Electronic-Emily/WeatherMonitoringSensors/README.md

# Weather Monitoring Project
Wind Direction Sensor with Display showing arrow

## Purpose
The purpose of this project is to create a prototype outdoor real-time weather monitoring station. The data from the station will then be transmitted and displayed to update the user on the current weather conditions.
   
The station's environmental sensing abilities should include:
- Temperature
- Atmospheric Pressure
- Relative Humidity
- Wind Speed (anemometer)
- Wind Direction
- Light Brightness

## Solution

For the first proof of concept a Nucleo-L4R5ZI-P (STM32L4R5ZI) dev board was chosen to interface with the sensors.

## Parts list
	
### Sensors	
  
  |      | Part # | Mfr. Name| Part Source                         |
|----------------|-------------------|--------------|------------------|
|Temperature          |Si7021-A20 | Silicon Labs | digikey.com |
|Relative Humidity    |Si7021-A20 | Silicon Labs | digikey.com  |
|Atmospheric Pressure | MS5803-02BA | TE Connectivity|  digikey.com |
|Light Brightness | VEML6035 | VISHAY | digikey.com |
|Wind Speed | ID: 1733 | | adafruit.com |
|Wind Direction | NA |  Self-Built | NA |

### Other Parts
  |                | Part #  |  Mfr. Name                    | Part Source                         |
|--------|--------|----------|-----------|
|Display Dev Board | 3.5" TFT 320x480 HXD8357D |  | adafruit.com |
|MCU Dev Board| Nucleo-L4R5ZI | STM  | digikey.com |

### Custom Wind Direction Sensor Parts
  |    | Part #  |  Mfr. Name      | Part Source      |
|------|-----|----|-----------|
|GPIO Expander | SX1502I087TRT | SEMTECH  | digikey.com |
|Reed-switches | PMC-0701S1015 | PIC GmbH | digikey.com |

## Doc Links
### Sensor Docs
Wind Direction Sensor - Documentation

Ambient Sensor Board - Documentation

Wind Speed Sensor

### Video Link
Wind Direction Sensor - Youtube video functionality test
