Electronic-Emily/WeatherMonitoringSensors/docs/Sensor_Board/README.md

# Ambient Sensor Board

Assembled Ambient Sensor Board

## Functionality
The ambient sensor board is a pcb with three surface mount sensors that provide the system temperature, humidity, atmospheric pressure, and light brightness. 
The MCU requests these metics through I2C. 
### Humidity Sensor
	Part: Si7021-A20
### Atmospheric Pressure Sensor
	Part: MS5803-02BA
### Light Sensor
	Part: VEML6035
## PCB
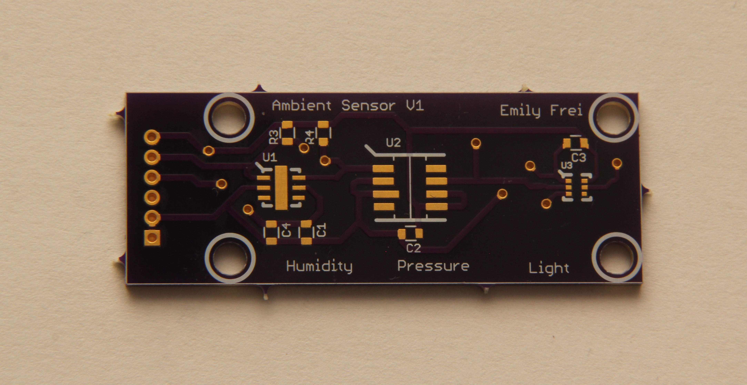
[picture p1: docs/Sensor_Board/SensorBoard_PCB_top.jpg]
Unpopulated Ambient Sensor Board

### Schematic
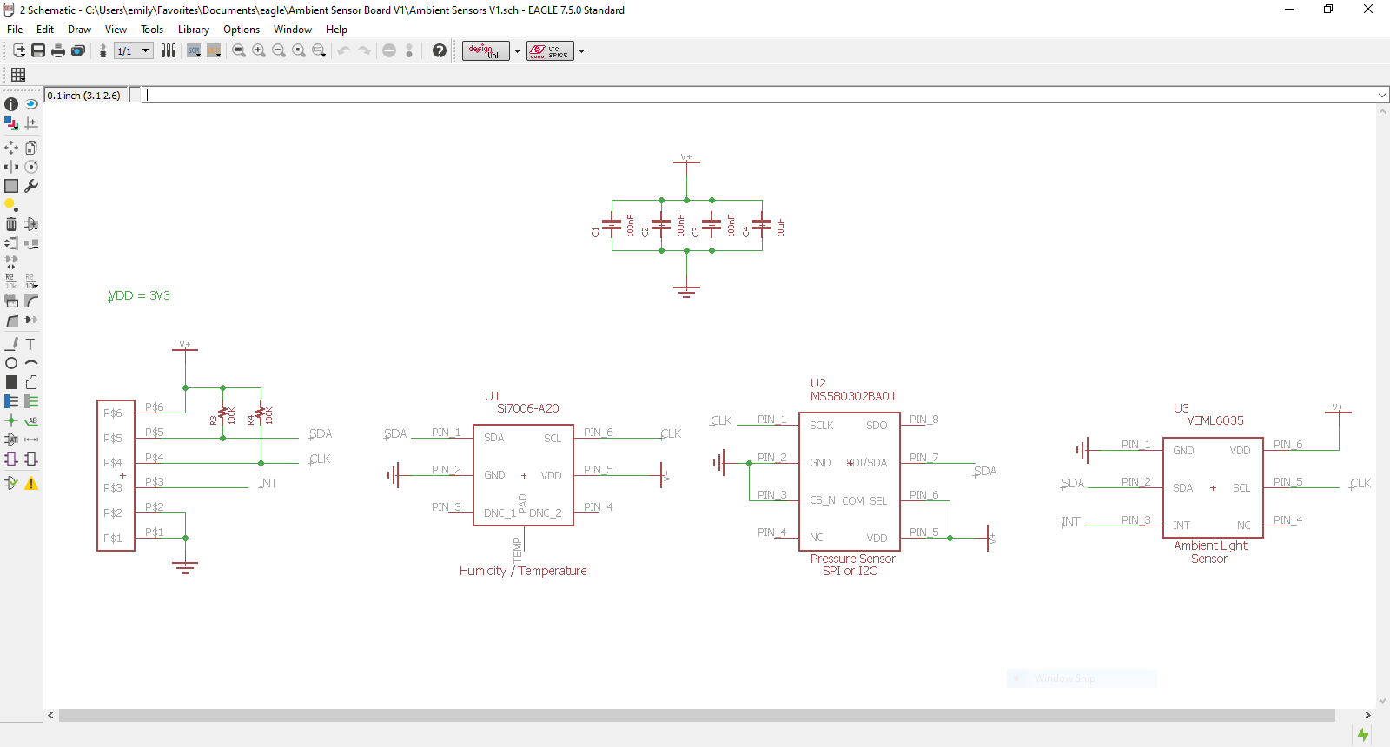
[picture p2: docs/Sensor_Board/SensorBoard_V1_SCH.PNG]
Ambient Sensor Board Schematic

### Board Layout
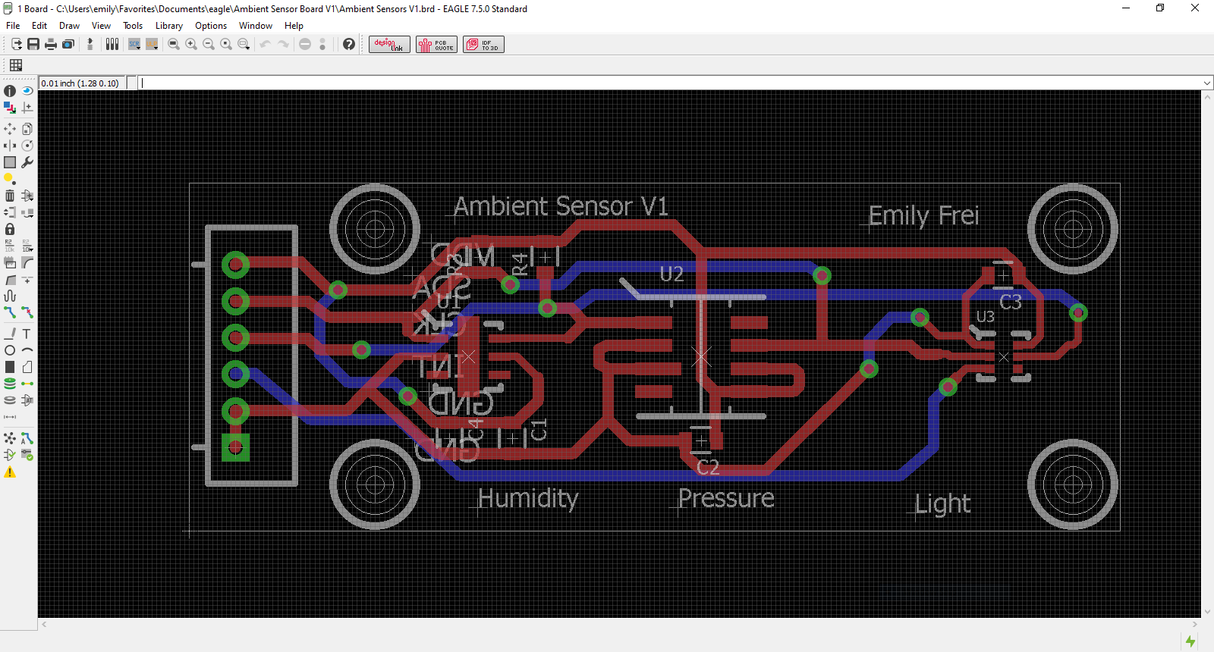
[picture p3: docs/Sensor_Board/SensorBoard_V1_PCB.PNG]
Ambient Sensor Board Layout
