Electronic-Emily/WeatherMonitoringSensors/docs/Wind_Sensor/pictures/Wind_Dir_V2_SCH.PNG

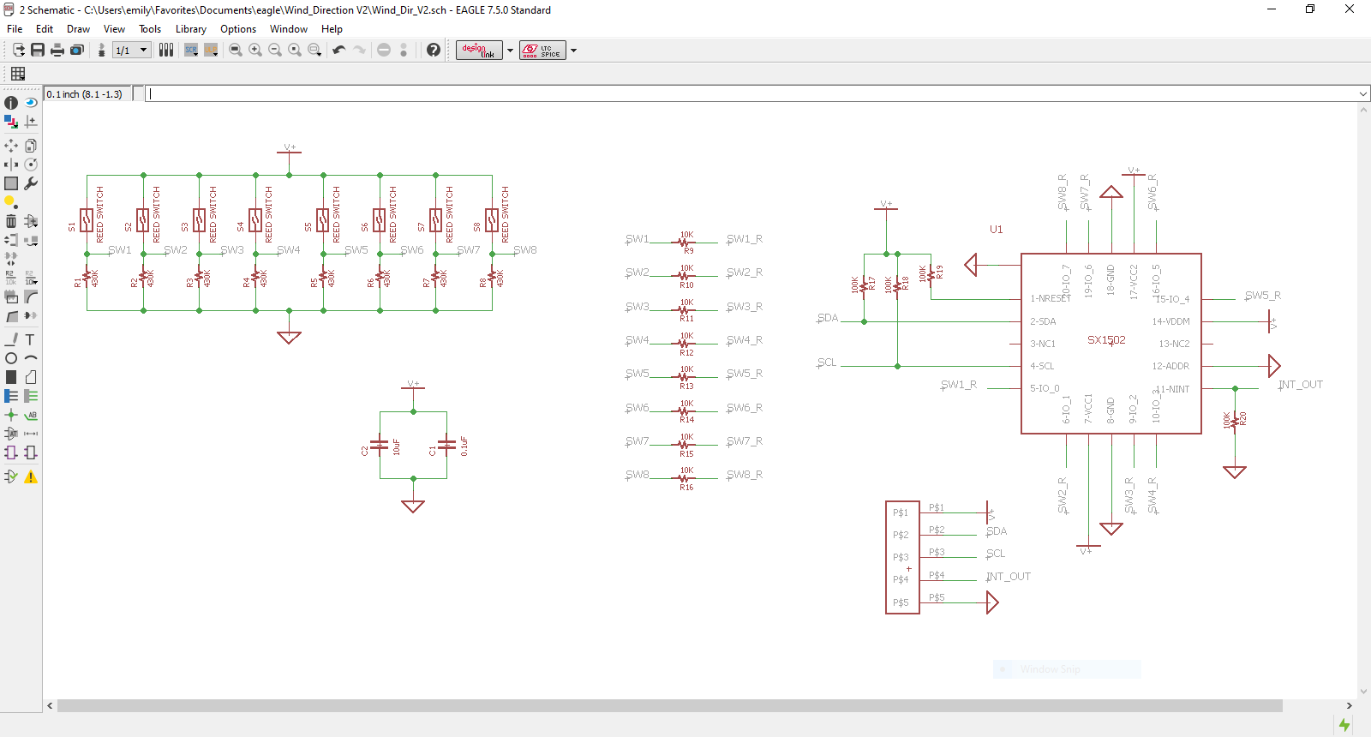
docs/Wind_Sensor/pictures/Wind_Dir_V2_SCH.PNG
