Electronic-Emily/WeatherMonitoringSensors/docs/Wind_Sensor/pictures/WindDirection_SensorV2_Half.PNG

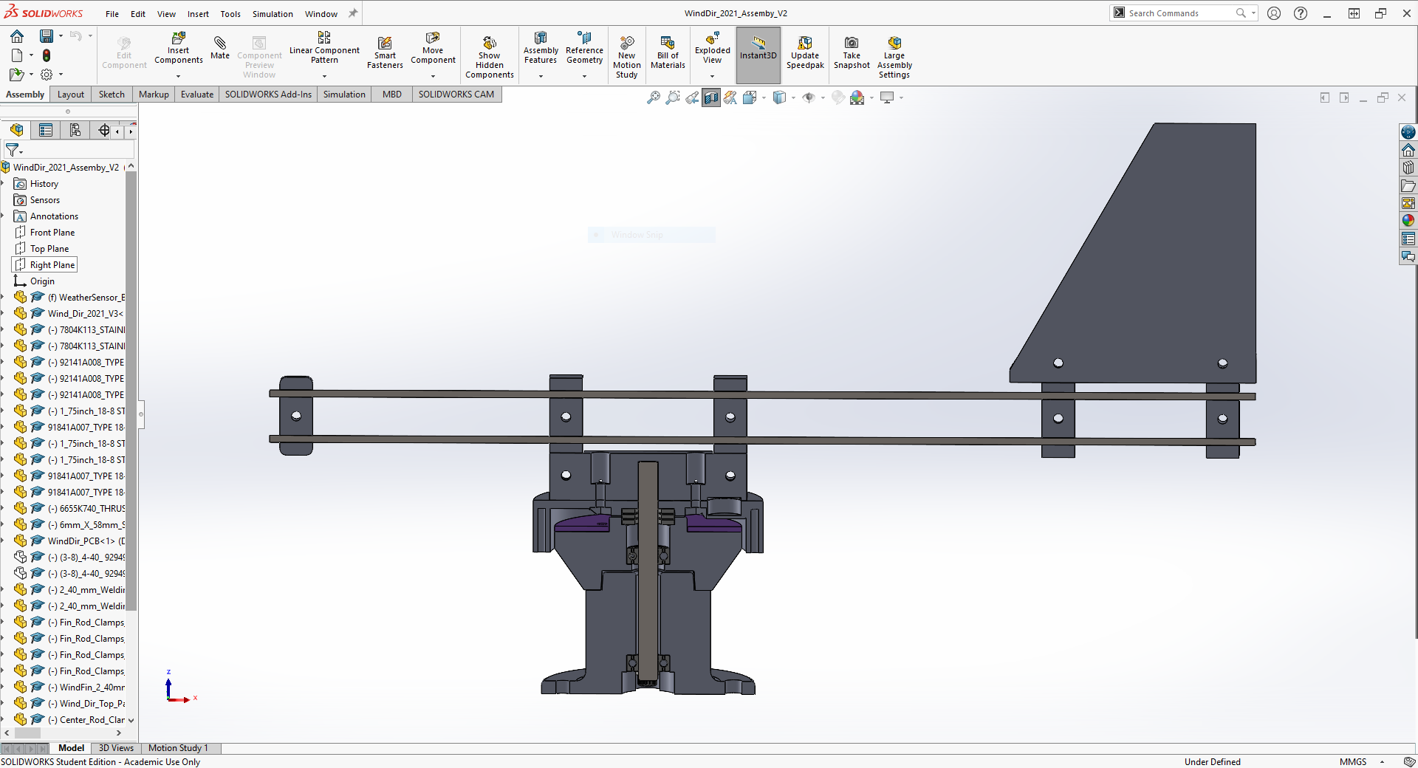
docs/Wind_Sensor/pictures/WindDirection_SensorV2_Half.PNG
