Electronic-Emily/WeatherMonitoringSensors/docs/Wind_Sensor/pictures/WindDirection_SensorV2_main.PNG

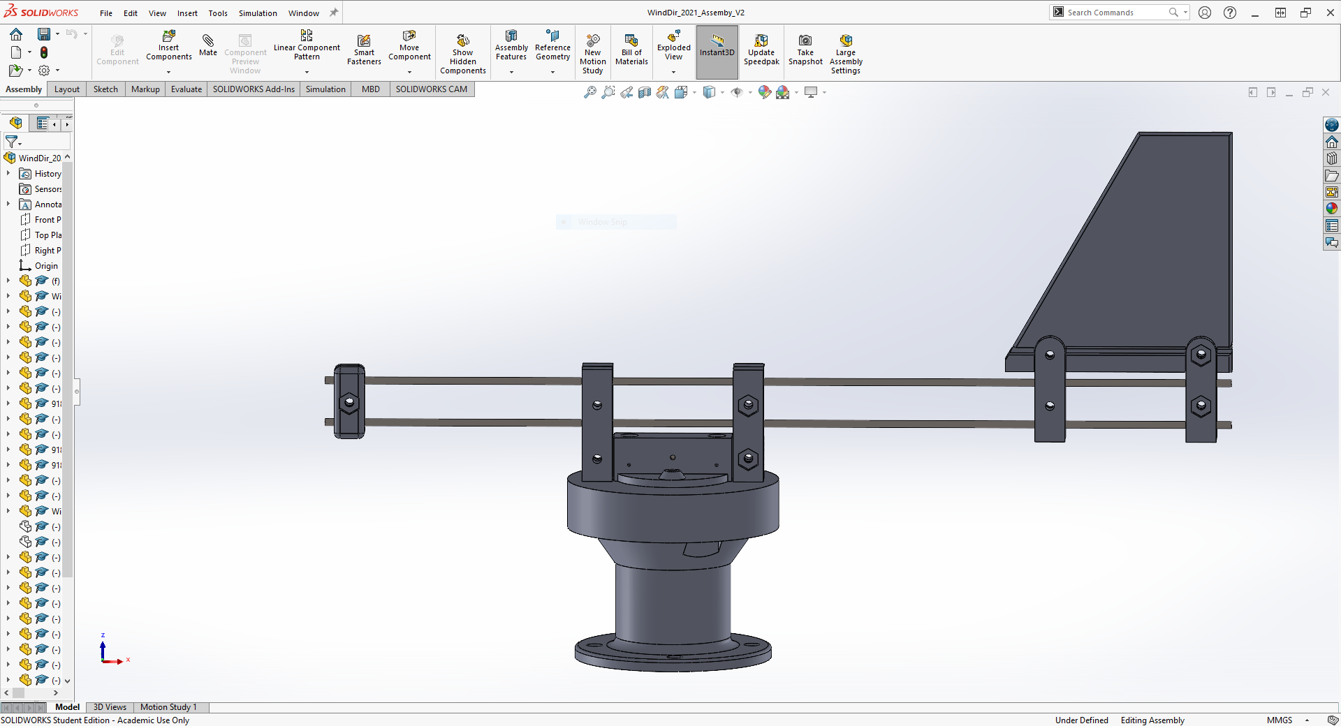
docs/Wind_Sensor/pictures/WindDirection_SensorV2_main.PNG
