Electronic-Emily/WeatherMonitoringSensors/docs/Wind_Sensor/pictures/WindDirection_SensorV2_main_angle.PNG

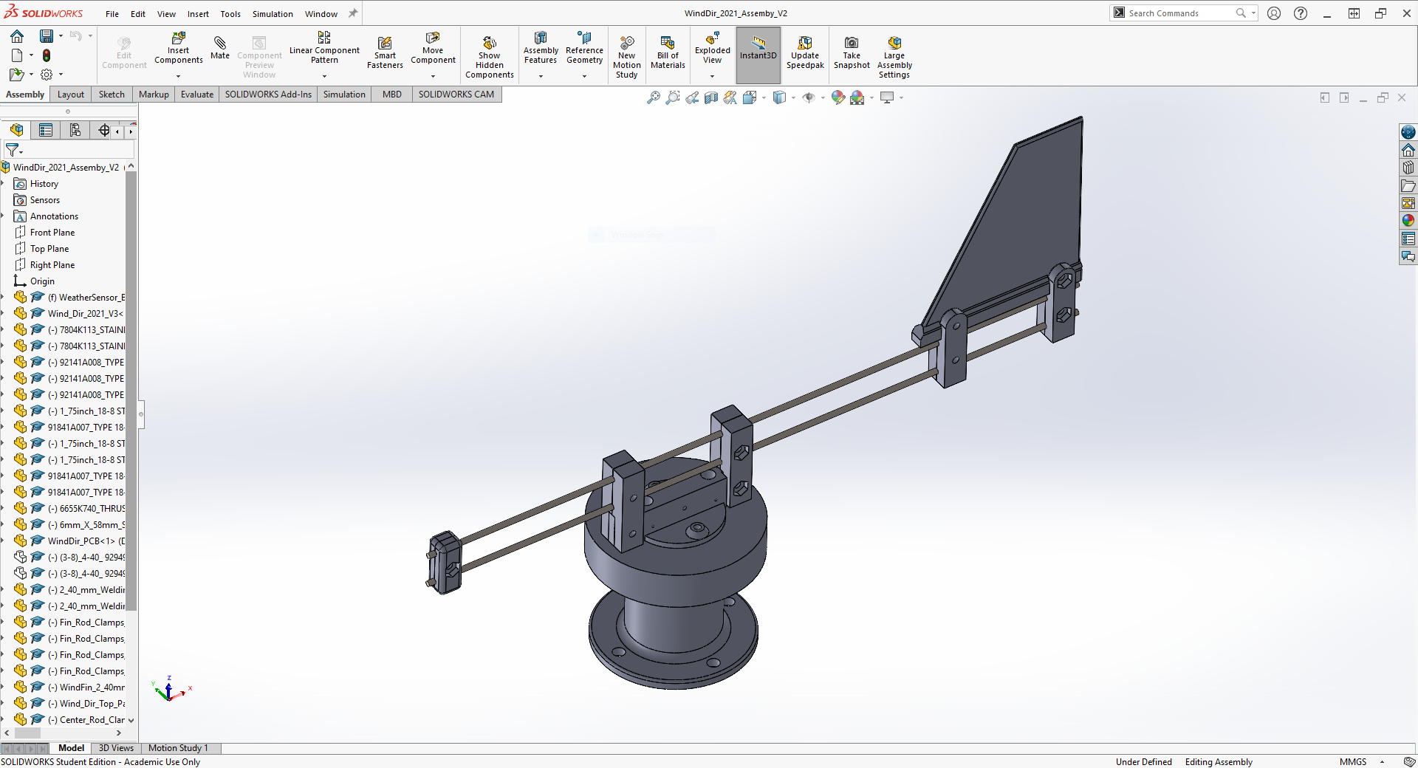
docs/Wind_Sensor/pictures/WindDirection_SensorV2_main_angle.PNG
