Electronic-Emily/WeatherMonitoringSensors/docs/Wind_Sensor/pictures/Assembled_With_Display.PNG

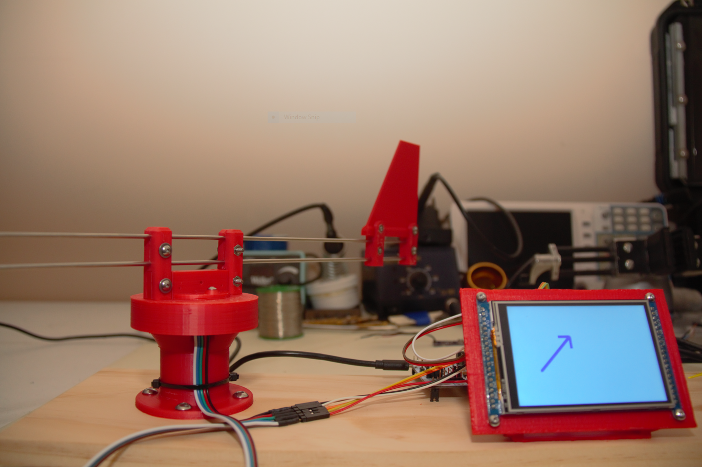
docs/Wind_Sensor/pictures/Assembled_With_Display.PNG
