Electronic-Emily/WeatherMonitoringSensors/docs/Wind_Sensor/pictures/WindDirect_Assembled_02.PNG

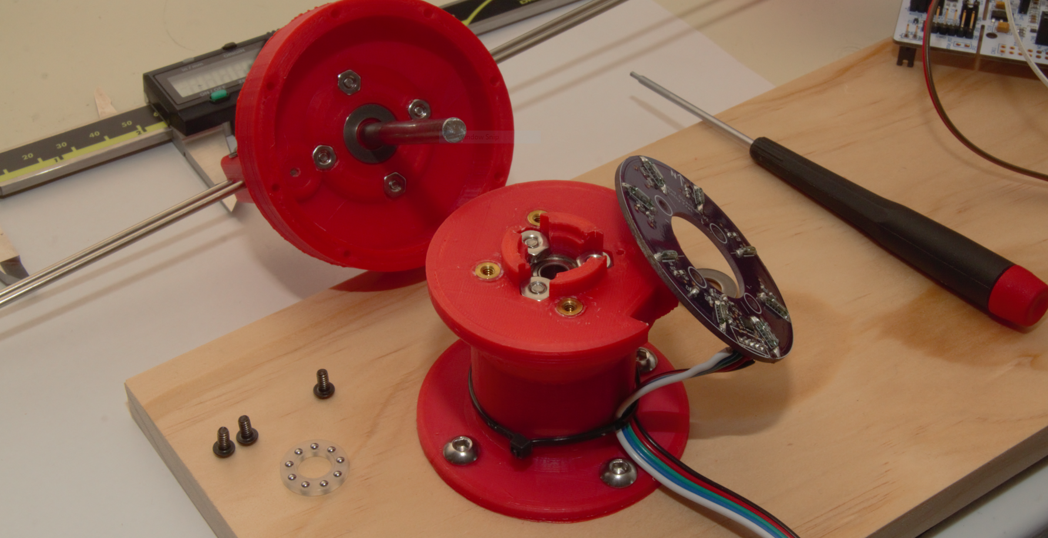
docs/Wind_Sensor/pictures/WindDirect_Assembled_02.PNG
