Electronic-Emily/WeatherMonitoringSensors/source Code/L4R5ZI_Base_01/Core/Src/main.c

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
/* Includes ------------------------------------------------------------------*/
#include "main.h"

/* USER CODE BEGIN Includes */
#include "stm32l4xx.h"
#include "lightSensor.h"
//#include "HumiditySensor.h"
//#include "PressureSensor.h"
#include "GPIO_Expander.h"
#include "Display_LCD.h"
/* USER CODE END Includes */

I2C_HandleTypeDef hi2c1;
I2C_HandleTypeDef hi2c2;

UART_HandleTypeDef hlpuart1;

SPI_HandleTypeDef hspi1;

void SystemClock_Config(void);
static void MX_GPIO_Init(void);
static void MX_LPUART1_UART_Init(void);
static void MX_SPI1_Init(void);
static void MX_I2C2_Init(void);
static void MX_I2C1_Init(void);
/* USER CODE BEGIN PFP */

volatile uint8_t ButtonActiveFlag;
volatile uint8_t WindDir_Flag;
Direction g_Disp_Direction;
/* USER CODE END PFP */

/* USER CODE BEGIN 0 */

SPI_HandleTypeDef* p_LCD_spi;

/* USER CODE END 0 */

/**
  * @brief  The application entry point.
  * @retval int
  */
int main(void)
{
  /* USER CODE BEGIN 1 */

	p_LCD_spi = &hspi1;
	ButtonActiveFlag = 0;
	WindDir_Flag = 0;
	g_Disp_Direction = NONE;

  /* USER CODE END 1 */

  /* MCU Configuration--------------------------------------------------------*/

  /* Reset of all peripherals, Initializes the Flash interface and the Systick. */
  HAL_Init();

  /* Configure the system clock */
  SystemClock_Config();

  /* Initialize all configured peripherals */
  MX_GPIO_Init();
  MX_LPUART1_UART_Init();
  MX_SPI1_Init();
  MX_I2C2_Init();
  MX_I2C1_Init();
  /* USER CODE BEGIN 2 */


  Init_External_GPIO();
  Init_LightSensor();


  /* USER CODE END 2 */

  /* Infinite loop */
    /* USER CODE BEGIN 3 */

  //Flash All On-board LEDs Once
  HAL_GPIO_WritePin(RED_LED_GPIO_Port, RED_LED_Pin, GPIO_PIN_SET);
  HAL_GPIO_WritePin(BLUE_LED_GPIO_Port, BLUE_LED_Pin, GPIO_PIN_SET);
  HAL_GPIO_WritePin(GREEN_LED_GPIO_Port, GREEN_LED_Pin, GPIO_PIN_SET);

  HAL_Delay(500);

  HAL_GPIO_WritePin(RED_LED_GPIO_Port, RED_LED_Pin, GPIO_PIN_RESET);
  HAL_GPIO_WritePin(BLUE_LED_GPIO_Port, BLUE_LED_Pin, GPIO_PIN_RESET);
  HAL_GPIO_WritePin(GREEN_LED_GPIO_Port, GREEN_LED_Pin, GPIO_PIN_RESET);

  uint8_t old_pinStatus = 0;
  uint8_t new_pinStatus = 0;
  uint16_t brightness = 0;

	while(1){

		//Init Display if button if pressed
		if(ButtonActiveFlag == 1){
			ButtonActiveFlag = 0;
			InitSystem_Display();
		}

		HAL_Delay(10);

		if (WindDir_Flag == 1) {
			//Disable Wind Dir ISR.
			HAL_NVIC_DisableIRQ(EXTI9_5_IRQn);
			//Reset Flag
			WindDir_Flag = 0;
			//Blink Blue LED as a visual that a change happened on the Direction Sensor
			HAL_GPIO_WritePin(BLUE_LED_GPIO_Port, BLUE_LED_Pin, GPIO_PIN_SET);
			HAL_Delay(50);
			HAL_GPIO_WritePin(BLUE_LED_GPIO_Port, BLUE_LED_Pin, GPIO_PIN_RESET);
			new_pinStatus = ReadPinStatus();

			//Clear GPIO exp. ISR
			ClearINT();

			//Enable Wind Dir ISR.
			HAL_NVIC_EnableIRQ(EXTI9_5_IRQn);
		}

		//Update wind Direction on display if a change occurred
		if ((new_pinStatus != old_pinStatus) && (new_pinStatus != 0)) {
			old_pinStatus = new_pinStatus;
			Update_Dir_Display(old_pinStatus);
		}

		//Get_Brightness(&brightness);

	}//while

  /* USER CODE END 3 */
}

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
