Electronic-Emily/WeatherMonitoringSensors/source Code/L4R5ZI_Base_01/L4R5ZI_Base_01.ioc

Mcu.UserName=STM32L4R5ZITxP
PA2.Signal=LPUART1_TX
PA3.Signal=LPUART1_RX
PB14.GPIO_Label=RED_LED
PB14.Signal=GPIO_Output
PB7.GPIO_Label=BLUE_LED
PB7.Signal=GPIO_Output
PB8.Signal=I2C1_SCL
PB9.Signal=I2C1_SDA
PC13.GPIO_Label=USER_BUTTON
PC13.Signal=GPXTI13
PC7.GPIO_Label=GREEN_LED
PC7.Signal=GPIO_Output
PE10.GPIO_Label=DATA_CMD_LCD
PE10.Signal=GPIO_Output
PE12.GPIO_Label=LCD_CS
PE12.Signal=GPIO_Output
PE13.Signal=SPI1_SCK
PE14.Signal=SPI1_MISO
PE15.Signal=SPI1_MOSI
PE5.GPIO_Label=WIND_DIR_INT
PE5.Signal=GPXTI5
PF0.Signal=I2C2_SDA
PF1.Signal=I2C2_SCL
