Electronic-Emily/WeatherMonitoringSensors/source Code/L4R5ZI_Base_01/Core/Inc/main.h

#define WIND_DIR_INT_Pin GPIO_PIN_5
#define WIND_DIR_INT_GPIO_Port GPIOE
#define WIND_DIR_INT_EXTI_IRQn EXTI9_5_IRQn
#define USER_BUTTON_Pin GPIO_PIN_13
#define USER_BUTTON_GPIO_Port GPIOC
#define USER_BUTTON_EXTI_IRQn EXTI15_10_IRQn
#define DATA_CMD_LCD_Pin GPIO_PIN_10
#define DATA_CMD_LCD_GPIO_Port GPIOE
#define LCD_CS_Pin GPIO_PIN_12
#define LCD_CS_GPIO_Port GPIOE
#define RED_LED_Pin GPIO_PIN_14
#define RED_LED_GPIO_Port GPIOB
#define GREEN_LED_Pin GPIO_PIN_7
#define GREEN_LED_GPIO_Port GPIOC
#define BLUE_LED_Pin GPIO_PIN_7
#define BLUE_LED_GPIO_Port GPIOB
