Electronic-Emily/WeatherMonitoringSensors/(commit log)

2021-09-12 Added Wind Dir Sensor Pics
2021-09-15 added wind direction sensor readme
2021-09-15 add Wind Sensor with display picture
2021-09-19 Got Brightness data from Sensor Board
2021-09-20 added sensor board pictures
2021-09-20 update sensor board info, Test
2021-09-20 updated readme file windspeed to include DC power supply
2021-09-20 added link to the windspeed sensor dir to main readme
